edgecollective/sweet-p/ver_0.3/firmware/grassnomads/v1.0_return/README.txt

This is the state of the code when the device was returned in late Nov 2023 in order to add gps + timing and swap in a new sensor.
