edgecollective/sweet-p/ver_1/firmware/bayou.png

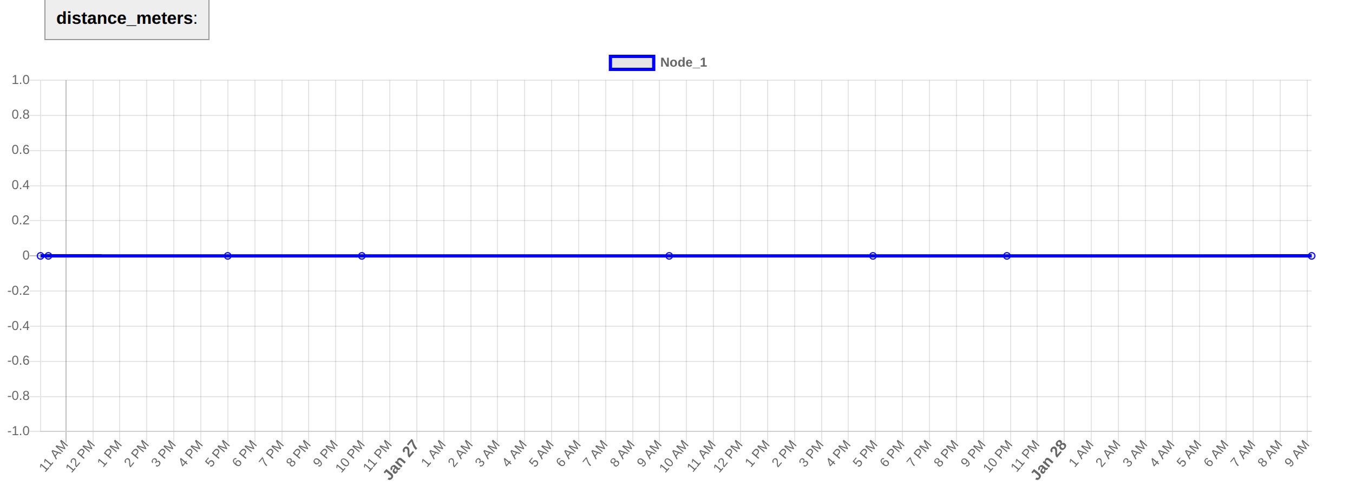
ver_1/firmware/bayou.png
