edgecollective/sweet-p/ver_0.4b/references/rockblock_cad/RockBLOCK_2_C.STEP

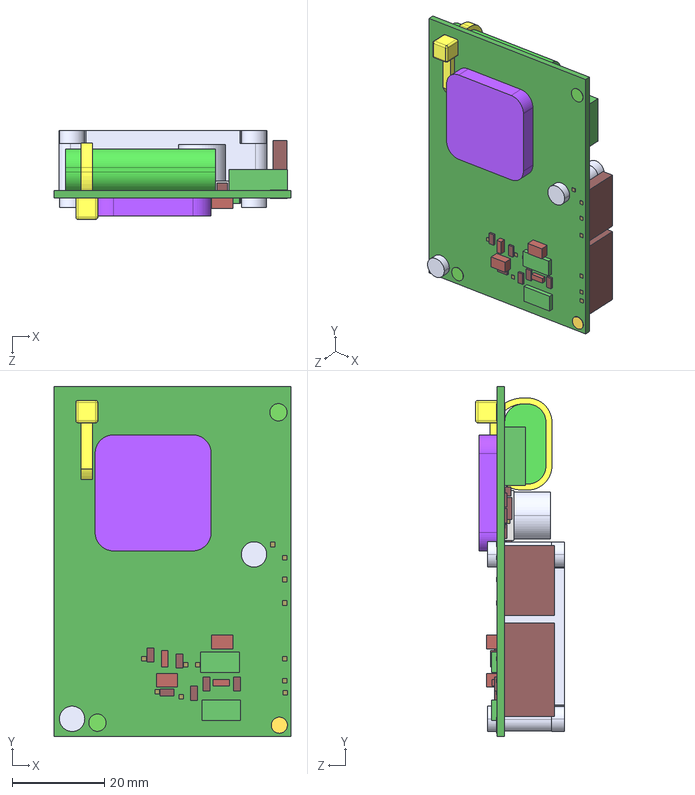
[picture p2: CAD file, 2023-05-05]
ver_0.4b/references/rockblock_cad/RockBLOCK_2_C.STEP
51.4 x 76.0 x 19.3 mm
