edgecollective/sweet-p/ver_1/modem_shelf/modem_shelf.stl

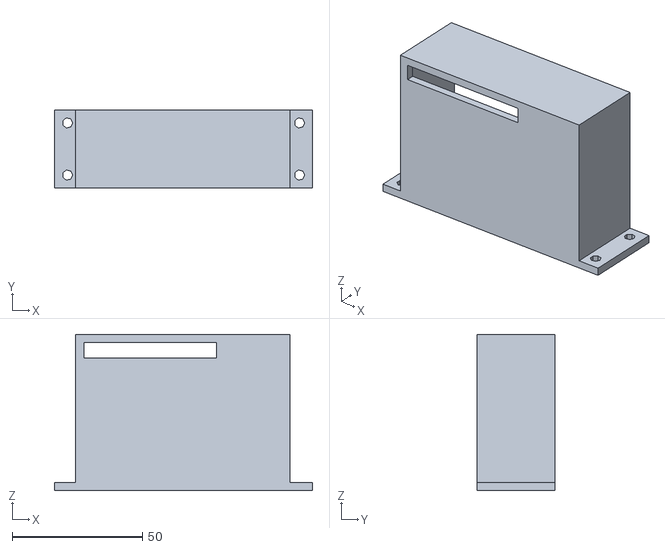
[picture p3: CAD file, 2025-12-08]
ver_1/modem_shelf/modem_shelf.stl
98.9 x 30.0 x 59.8
