edgecollective/sweet-p/(list of files, cad)

Other CAD files:
ver_0.4b/references/rockblock_cad/RockBLOCK_2_C (SMA).IGS
ver_0.4b/references/rockblock_cad/RockBLOCK_2_C.IGS
