edgecollective/sweet-p/ver_1/power_tests/3v3_to_adafruit_boost_1000.csv

Timestamp(ms) | Current(uA) | D0-D7
0 | 893.618 | 00000000
1000 | 328.765 | 00000000
2000 | 120.964 | 00000000
3000 | 44.520 | 00000000
4000 | 16.396 | 00000000
5000 | 6.052 | 00000000
6000 | 2763.313 | 00000000
7000 | 9912.000 | 00000000
8000 | 13029.475 | 00000000
9000 | 14181.139 | 00000000
10000 | 14470.309 | 00000000
11000 | 15074.997 | 00000000
12000 | 15029.870 | 00000000
13000 | 15384.849 | 00000000
14000 | 15185.409 | 00000000
15000 | 15153.102 | 00000000
16000 | 15122.245 | 00000000
17000 | 14982.114 | 00000000
18000 | 14971.494 | 00000000
19000 | 14884.330 | 00000000
20000 | 14808.294 | 00000000
21000 | 14660.663 | 00000000
22000 | 14685.264 | 00000000
23000 | 10569.829 | 00000000
24000 | 7407.893 | 00000000
25000 | 6232.191 | 00000000
26000 | 5717.780 | 00000000
27000 | 5602.246 | 00000000
28000 | 5492.494 | 00000000
29000 | 5421.319 | 00000000
30000 | 5391.076 | 00000000
31000 | 5364.958 | 00000000
32000 | 5301.172 | 00000000
33000 | 5254.912 | 00000000
34000 | 5259.111 | 00000000
35000 | 5226.554 | 00000000
36000 | 5184.181 | 00000000
37000 | 5135.263 | 00000000
38000 | 5225.625 | 00000000
39000 | 5140.500 | 00000000
40000 | 5096.870 | 00000000
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
