edgecollective/sweet-p/ver_1/power_tests/3v3_to_adafruit_boost_with_sat_send.csv

Timestamp(ms) | Current(uA) | D0-D7
0 | 4711.232 | 00000000
10 | 4684.063 | 00000000
20 | 4508.034 | 00000000
30 | 4260.355 | 00000000
40 | 4017.081 | 00000000
50 | 3752.968 | 00000000
60 | 4064.977 | 00000000
70 | 3647.355 | 00000000
80 | 3818.053 | 00000000
90 | 3707.150 | 00000000
100 | 3705.720 | 00000000
110 | 4114.174 | 00000000
120 | 4046.989 | 00000000
130 | 4182.540 | 00000000
140 | 4110.196 | 00000000
150 | 4055.243 | 00000000
160 | 3923.804 | 00000000
170 | 3990.117 | 00000000
180 | 4363.126 | 00000000
190 | 3653.594 | 00000000
200 | 3743.150 | 00000000
210 | 3729.171 | 00000000
220 | 4014.052 | 00000000
230 | 3737.505 | 00000000
240 | 3727.884 | 00000000
250 | 3765.068 | 00000000
260 | 3748.979 | 00000000
270 | 3766.070 | 00000000
280 | 3608.509 | 00000000
290 | 3885.023 | 00000000
300 | 4092.578 | 00000000
310 | 4128.807 | 00000000
320 | 4155.380 | 00000000
330 | 4290.182 | 00000000
340 | 4132.554 | 00000000
350 | 3974.280 | 00000000
360 | 4153.649 | 00000000
370 | 4197.875 | 00000000
380 | 4343.990 | 00000000
390 | 4159.344 | 00000000
400 | 3991.450 | 00000000
410 | 4021.465 | 00000000
420 | 4406.368 | 00000000
430 | 3996.783 | 00000000
440 | 4149.331 | 00000000
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
