edgecollective/sweet-p/ver_1/power_tests/5v_direct_to_5V_timer.csv

Timestamp(ms) | Current(uA) | D0-D7
0 | 0.450 | 00000000
1000 | 0.417 | 00000000
2000 | 0.403 | 00000000
3000 | 0.400 | 00000000
4000 | 0.397 | 00000000
5000 | 0.402 | 00000000
6000 | 8020.614 | 00000000
7000 | 13746.493 | 00000000
8000 | 16043.112 | 00000000
9000 | 16042.970 | 00000000
10000 | 17601.664 | 00000000
11000 | 17647.559 | 00000000
12000 | 18718.426 | 00000000
13000 | 18962.887 | 00000000
14000 | 19051.184 | 00000000
15000 | 19063.414 | 00000000
16000 | 19054.027 | 00000000
17000 | 19532.229 | 00000000
18000 | 19453.771 | 00000000
19000 | 19283.441 | 00000000
20000 | 19206.611 | 00000000
21000 | 19178.738 | 00000000
22000 | 19155.977 | 00000000
23000 | 19137.457 | 00000000
24000 | 19126.262 | 00000000
25000 | 19111.102 | 00000000
26000 | 19102.500 | 00000000
27000 | 19084.166 | 00000000
28000 | 20562.332 | 00000000
29000 | 20379.383 | 00000000
30000 | 19892.955 | 00000000
31000 | 19575.816 | 00000000
32000 | 19622.930 | 00000000
33000 | 19717.965 | 00000000
34000 | 19896.803 | 00000000
35000 | 20085.561 | 00000000
36000 | 19633.721 | 00000000
37000 | 19504.172 | 00000000
38000 | 20671.521 | 00000000
39000 | 25430.527 | 00000000
40000 | 34560.559 | 00000000
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
