edgecollective/sweet-p/ver_1/power_tests/amazon_boost_from_5V_direct_jan_14_2142.csv

Timestamp(ms) | Current(uA) | D0-D7
0 | 114937.688 | 00000000
1000 | 121255.969 | 00000000
2000 | 126080.289 | 00000000
3000 | 130029.781 | 00000000
4000 | 133418.047 | 00000000
5000 | 136607.484 | 00000000
6000 | 139536.828 | 00000000
7000 | 142125.109 | 00000000
8000 | 143671.891 | 00000000
9000 | 142532.438 | 00000000
10000 | 137865.125 | 00000000
11000 | 132348.594 | 00000000
12000 | 127357.805 | 00000000
13000 | 122535.289 | 00000000
14000 | 118210.492 | 00000000
15000 | 114508.422 | 00000000
16000 | 111995.164 | 00000000
17000 | 108680.805 | 00000000
18000 | 106043.789 | 00000000
19000 | 103910.211 | 00000000
20000 | 101921.086 | 00000000
21000 | 101176.305 | 00000000
22000 | 104139.992 | 00000000
23000 | 108209.227 | 00000000
24000 | 112506.328 | 00000000
25000 | 116837.414 | 00000000
26000 | 121263.555 | 00000000
27000 | 125396.406 | 00000000
28000 | 129110.453 | 00000000
29000 | 132328.672 | 00000000
30000 | 135395.438 | 00000000
31000 | 138301.094 | 00000000
32000 | 141015.188 | 00000000
33000 | 143397.016 | 00000000
34000 | 144036.328 | 00000000
35000 | 139848.938 | 00000000
36000 | 134449.531 | 00000000
37000 | 129028.578 | 00000000
38000 | 123875.164 | 00000000
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
