edgecollective/sweet-p/ver_1/power_tests/ave_over_many_non_sends.csv

Timestamp(ms) | Current(uA) | D0-D7
0 | 393.370 | 00000000
1000 | 144.728 | 00000000
2000 | 53.250 | 00000000
3000 | 1105.946 | 00000000
4000 | 12868.263 | 00000000
5000 | 18156.475 | 00000000
6000 | 20253.467 | 00000000
7000 | 20578.154 | 00000000
8000 | 22172.422 | 00000000
9000 | 22199.475 | 00000000
10000 | 23359.641 | 00000000
11000 | 23327.826 | 00000000
12000 | 23318.816 | 00000000
13000 | 23367.193 | 00000000
14000 | 23320.934 | 00000000
15000 | 23327.588 | 00000000
16000 | 23308.443 | 00000000
17000 | 23325.521 | 00000000
18000 | 23295.471 | 00000000
19000 | 23359.605 | 00000000
20000 | 14575.374 | 00000000
21000 | 5985.008 | 00000000
22000 | 2813.862 | 00000000
23000 | 1656.904 | 00000000
24000 | 1237.142 | 00000000
25000 | 1094.937 | 00000000
26000 | 1021.700 | 00000000
27000 | 1010.118 | 00000000
28000 | 996.412 | 00000000
29000 | 970.329 | 00000000
30000 | 981.474 | 00000000
31000 | 996.055 | 00000000
32000 | 1000.156 | 00000000
33000 | 972.854 | 00000000
34000 | 973.917 | 00000000
35000 | 987.651 | 00000000
36000 | 1000.270 | 00000000
37000 | 974.423 | 00000000
38000 | 985.599 | 00000000
39000 | 991.062 | 00000000
40000 | 980.608 | 00000000
41000 | 990.356 | 00000000
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
