edgecollective/sweet-p/ver_1/power_tests/boost_and_sat_full_cycle.csv

Timestamp(ms) | Current(uA) | D0-D7
0 | 388.027 | 00000000
1000 | 142.770 | 00000000
2000 | 483323.281 | 00000000
3000 | 888664.375 | 00000000
4000 | 1034955.625 | 00000000
5000 | 1091002.500 | 00000000
6000 | 1066258.875 | 00000000
7000 | 901453.188 | 00000000
8000 | 753140.688 | 00000000
9000 | 632702.063 | 00000000
10000 | 536028.313 | 00000000
11000 | 461830.063 | 00000000
12000 | 402696.938 | 00000000
13000 | 354787.250 | 00000000
14000 | 316307.375 | 00000000
15000 | 283209.938 | 00000000
16000 | 255524.969 | 00000000
17000 | 231928.516 | 00000000
18000 | 211351.297 | 00000000
19000 | 194154.375 | 00000000
20000 | 179773.734 | 00000000
21000 | 171463.656 | 00000000
22000 | 158958.438 | 00000000
23000 | 143430.047 | 00000000
24000 | 132808.500 | 00000000
25000 | 120411.609 | 00000000
26000 | 109782.992 | 00000000
27000 | 101049.172 | 00000000
28000 | 94261.555 | 00000000
29000 | 88413.359 | 00000000
30000 | 83443.773 | 00000000
31000 | 79172.977 | 00000000
32000 | 74864.313 | 00000000
33000 | 70709.469 | 00000000
34000 | 79750.367 | 00000000
35000 | 95003.711 | 00000000
36000 | 111140.719 | 00000000
37000 | 128621.125 | 00000000
38000 | 140207.609 | 00000000
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
