edgecollective/sweet-p/ver_1/sweet-p.kicad_pcb

## KiCad design ver_1/sweet-p.kicad_pcb (2025-10-10)

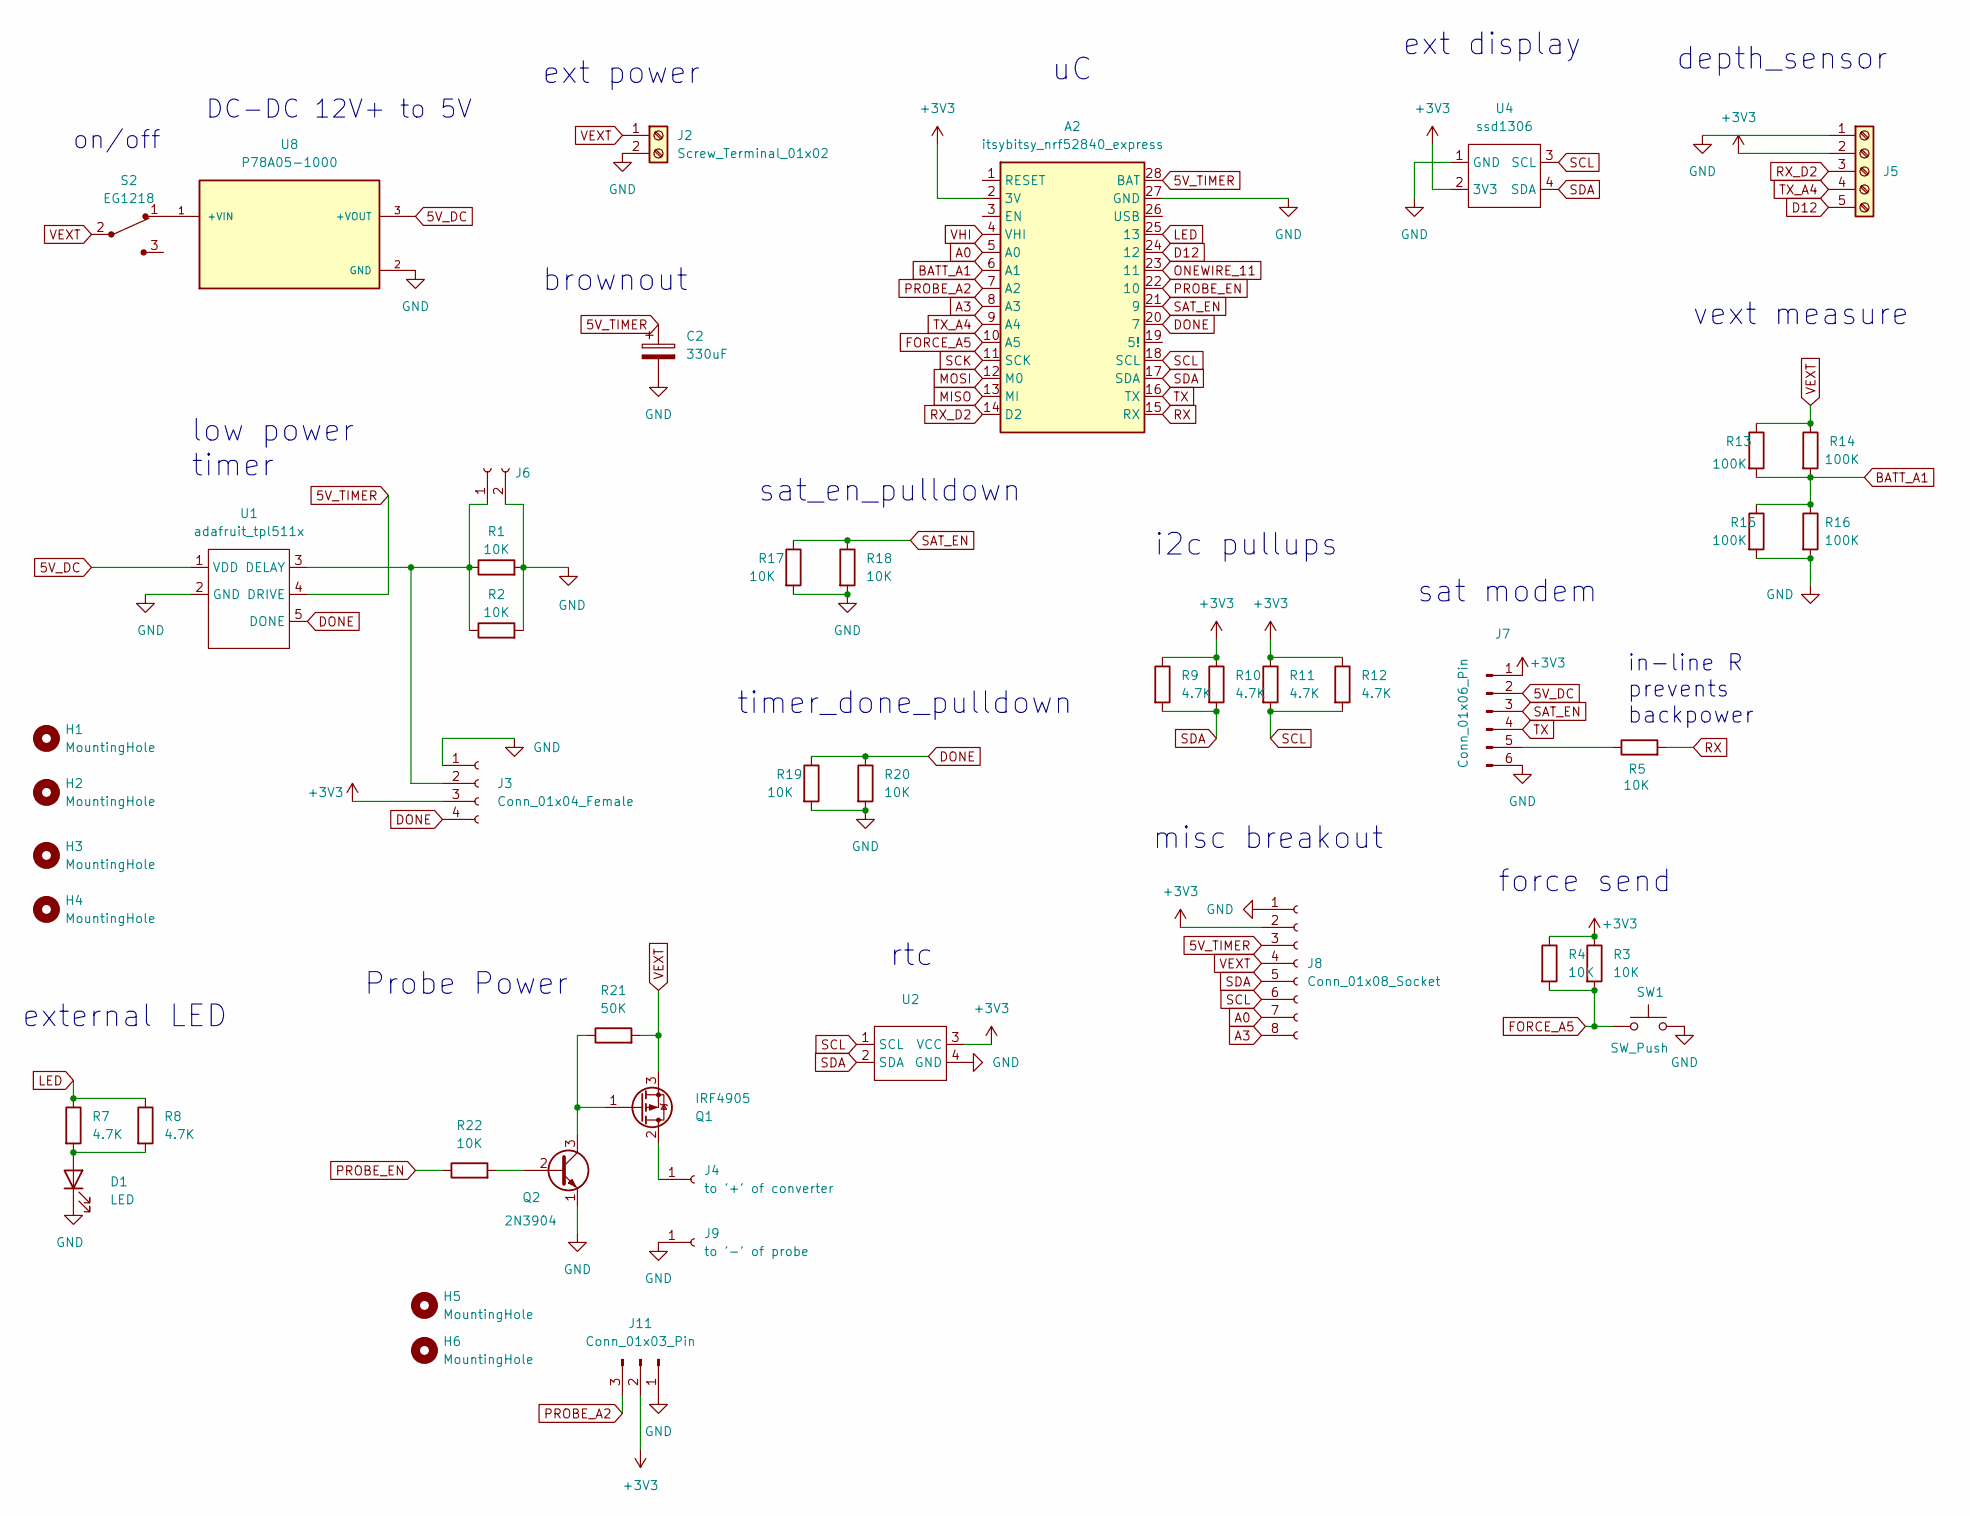
[picture p5: schematic sweet-p.kicad_sch]

Parts:
A2: itsybitsy_nrf52840_express; itsybitsy
C2: 330uF; CP_Radial_D5.0mm_P2.00mm
D1: LED; LED_D5.0mm
H1, H2, H3, H4, H5, H6: MountingHole; MountingHole_3.2mm_M3
J2: Screw_Terminal_01x02; TerminalBlock_Phoenix_PT-1,5-2-5.0-H_1x02_P5.00mm_Horizontal
J3: Conn_01x04_Female; PinSocket_1x04_P2.54mm_Vertical
J4: to '+' of converter; PinSocket_1x01_P2.54mm_Vertical
J5: Screw_Terminal_01x05; TerminalBlock_Phoenix_MKDS-1,5-5-5.08_1x05_P5.08mm_Horizont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
J6: Conn_01x02_Socket; PinSocket_1x02_P2.54mm_Vertical
J7: Conn_01x06_Pin; PinHeader_1x06_P2.54mm_Vertical
J8: Conn_01x08_Socket; PinSocket_1x08_P2.54mm_Vertical
J9: to '-' of probe; PinSocket_1x01_P2.54mm_Vertical
J11: Conn_01x03_Pin; PinHeader_1x03_P2.54mm_Vertical
Q1: IRF4905; TO-220-3_Vertical
Q2: 2N3904; TO-92_Inline
R1, R3, R18, R20: 10K; R_0603_1608Metric_Pad0.98x0.95mm_HandSolder
R2, R4, R5, R17, R19, R22: 10K; R_Axial_DIN0204_L3.6mm_D1.6mm_P7.62mm_Horizontal
R7, R9, R12: 4.7K; R_Axial_DIN0204_L3.6mm_D1.6mm_P7.62mm_Horizontal
R8, R10, R11: 4.7K; R_0603_1608Metric_Pad0.98x0.95mm_HandSolder
R13, R15: 100K; R_Axial_DIN0204_L3.6mm_D1.6mm_P7.62mm_Horizontal
R14, R16: 100K; R_0603_1608Metric_Pad0.98x0.95mm_HandSolder
R21: 50K; R_Axial_DIN0204_L3.6mm_D1.6mm_P7.62mm_Horizontal
S2: EG1218; Switch_Slide_11.6x4mm_EG1218; MPN EG1218; Digi-Key_PN EG1903-ND
SW1: SW_Push; SW_PUSH_6mm
U1: adafruit_tpl511x
U2: ds3231_amazon
U4: ssd1306; ssd1306_a
U8: P78A05-1000; CONV_P78A05-1000; PARTREV 1.0

Connections:
5V_DC: J7.2, U1.1 (VDD), U8.3 (+VOUT)
5V_TIMER: A2.28 (BAT), C2.1, J8.3, U1.4 (DRIVE)
+3V3: A2.2 (3V), J3.3, J5.2, J7.1, J8.2, J11.2, R3.1, R4.1, R9.1, R10.1, R11.1, R12.1, U2.3 (VCC), U4.2 (3V3)
A0: A2.5 (A0), J8.7
A3: A2.8 (A3), J8.8
BATT_A1: A2.6 (A1), R13.2, R14.2, R15.1, R16.1
D12: A2.24 (12), J5.5
DONE: A2.20 (7), J3.4, R19.1, R20.1, U1.5 (DONE)
FORCE_A5: A2.10 (A5), R3.2, R4.2, SW1.1
GND: A2.27 (GND), C2.2, D1.1 (K), J2.2, J3.1, J5.1, J6.2, J7.6, J8.1, J9.1, J11.1, Q2.1 (E), R1.2, R2.2, R15.2, R16.2, R17.2, R18.2, R19.2, R20.2, SW1.2, U1.2 (GND), U2.4 (GND), U4.1 (GND), U8.2 (GND)
LED: A2.25 (13), R7.1, R8.1
MISO: A2.13 (MI)
MOSI: A2.12 (M0)
unnamed: D1.2 (A), R7.2, R8.2
unnamed: J3.2, J6.1, R1.1, R2.1, U1.3 (DELAY)
unnamed: J4.1, Q1.2 (D)
unnamed: J7.5, R5.1
unnamed: Q1.1 (G), Q2.3 (C), R21.1
unnamed: Q2.2 (B), R22.2
unnamed: S2.1, U8.1 (+VIN)
ONEWIRE_11: A2.23 (11)
PROBE_A2: A2.7 (A2), J11.3
PROBE_EN: A2.22 (10), R22.1
RX: A2.15 (RX), R5.2
RX_D2: A2.14 (D2), J5.3
SAT_EN: A2.21 (9), J7.3, R17.1, R18.1
SCK: A2.11 (SCK)
SCL: A2.18 (SCL), J8.6, R11.2, R12.2, U2.1 (SCL), U4.3 (SCL)
SDA: A2.17 (SDA), J8.5, R9.2, R10.2, U2.2 (SDA), U4.4 (SDA)
TX: A2.16 (TX), J7.4
TX_A4: A2.9 (A4), J5.4
VEXT: J2.1, J8.4, Q1.3 (S), R13.1, R14.1, R21.2, S2.2
VHI: A2.4 (VHI)

Notes on the sheet:
force send
sat modem
brownout
DC-DC 12V+ to 5V
sat_en_pulldown
vext measure
misc breakout
timer_done_pulldown
in-line R prevents backpower
on/off
i2c pullups
external LED
depth_sensor
low power timer
ext power
ext display
Probe Power
rtc

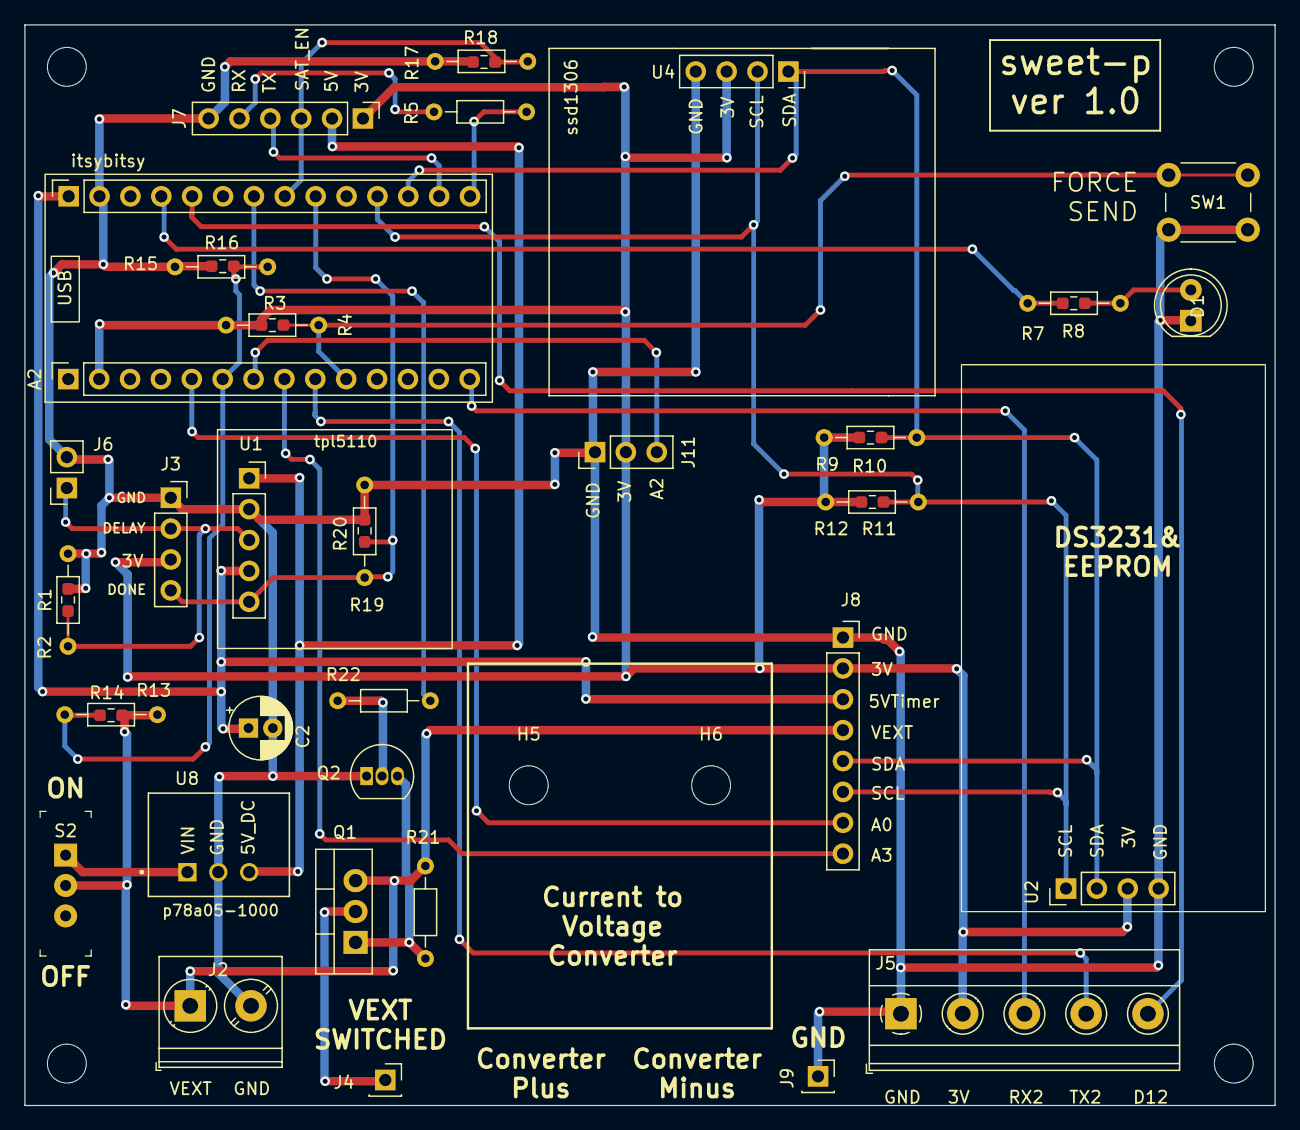
[picture p6: board ver_1/sweet-p.kicad_pcb from above]

Board: 2 copper layers, 102.8 x 88.9 mm, 47 parts (0 on the bottom side), 28 nets.
