edgecollective/sweet-p/ver_0.3/sweet-p.kicad_pcb

## KiCad design ver_0.3/sweet-p.kicad_pcb (2023-07-26, an earlier design)

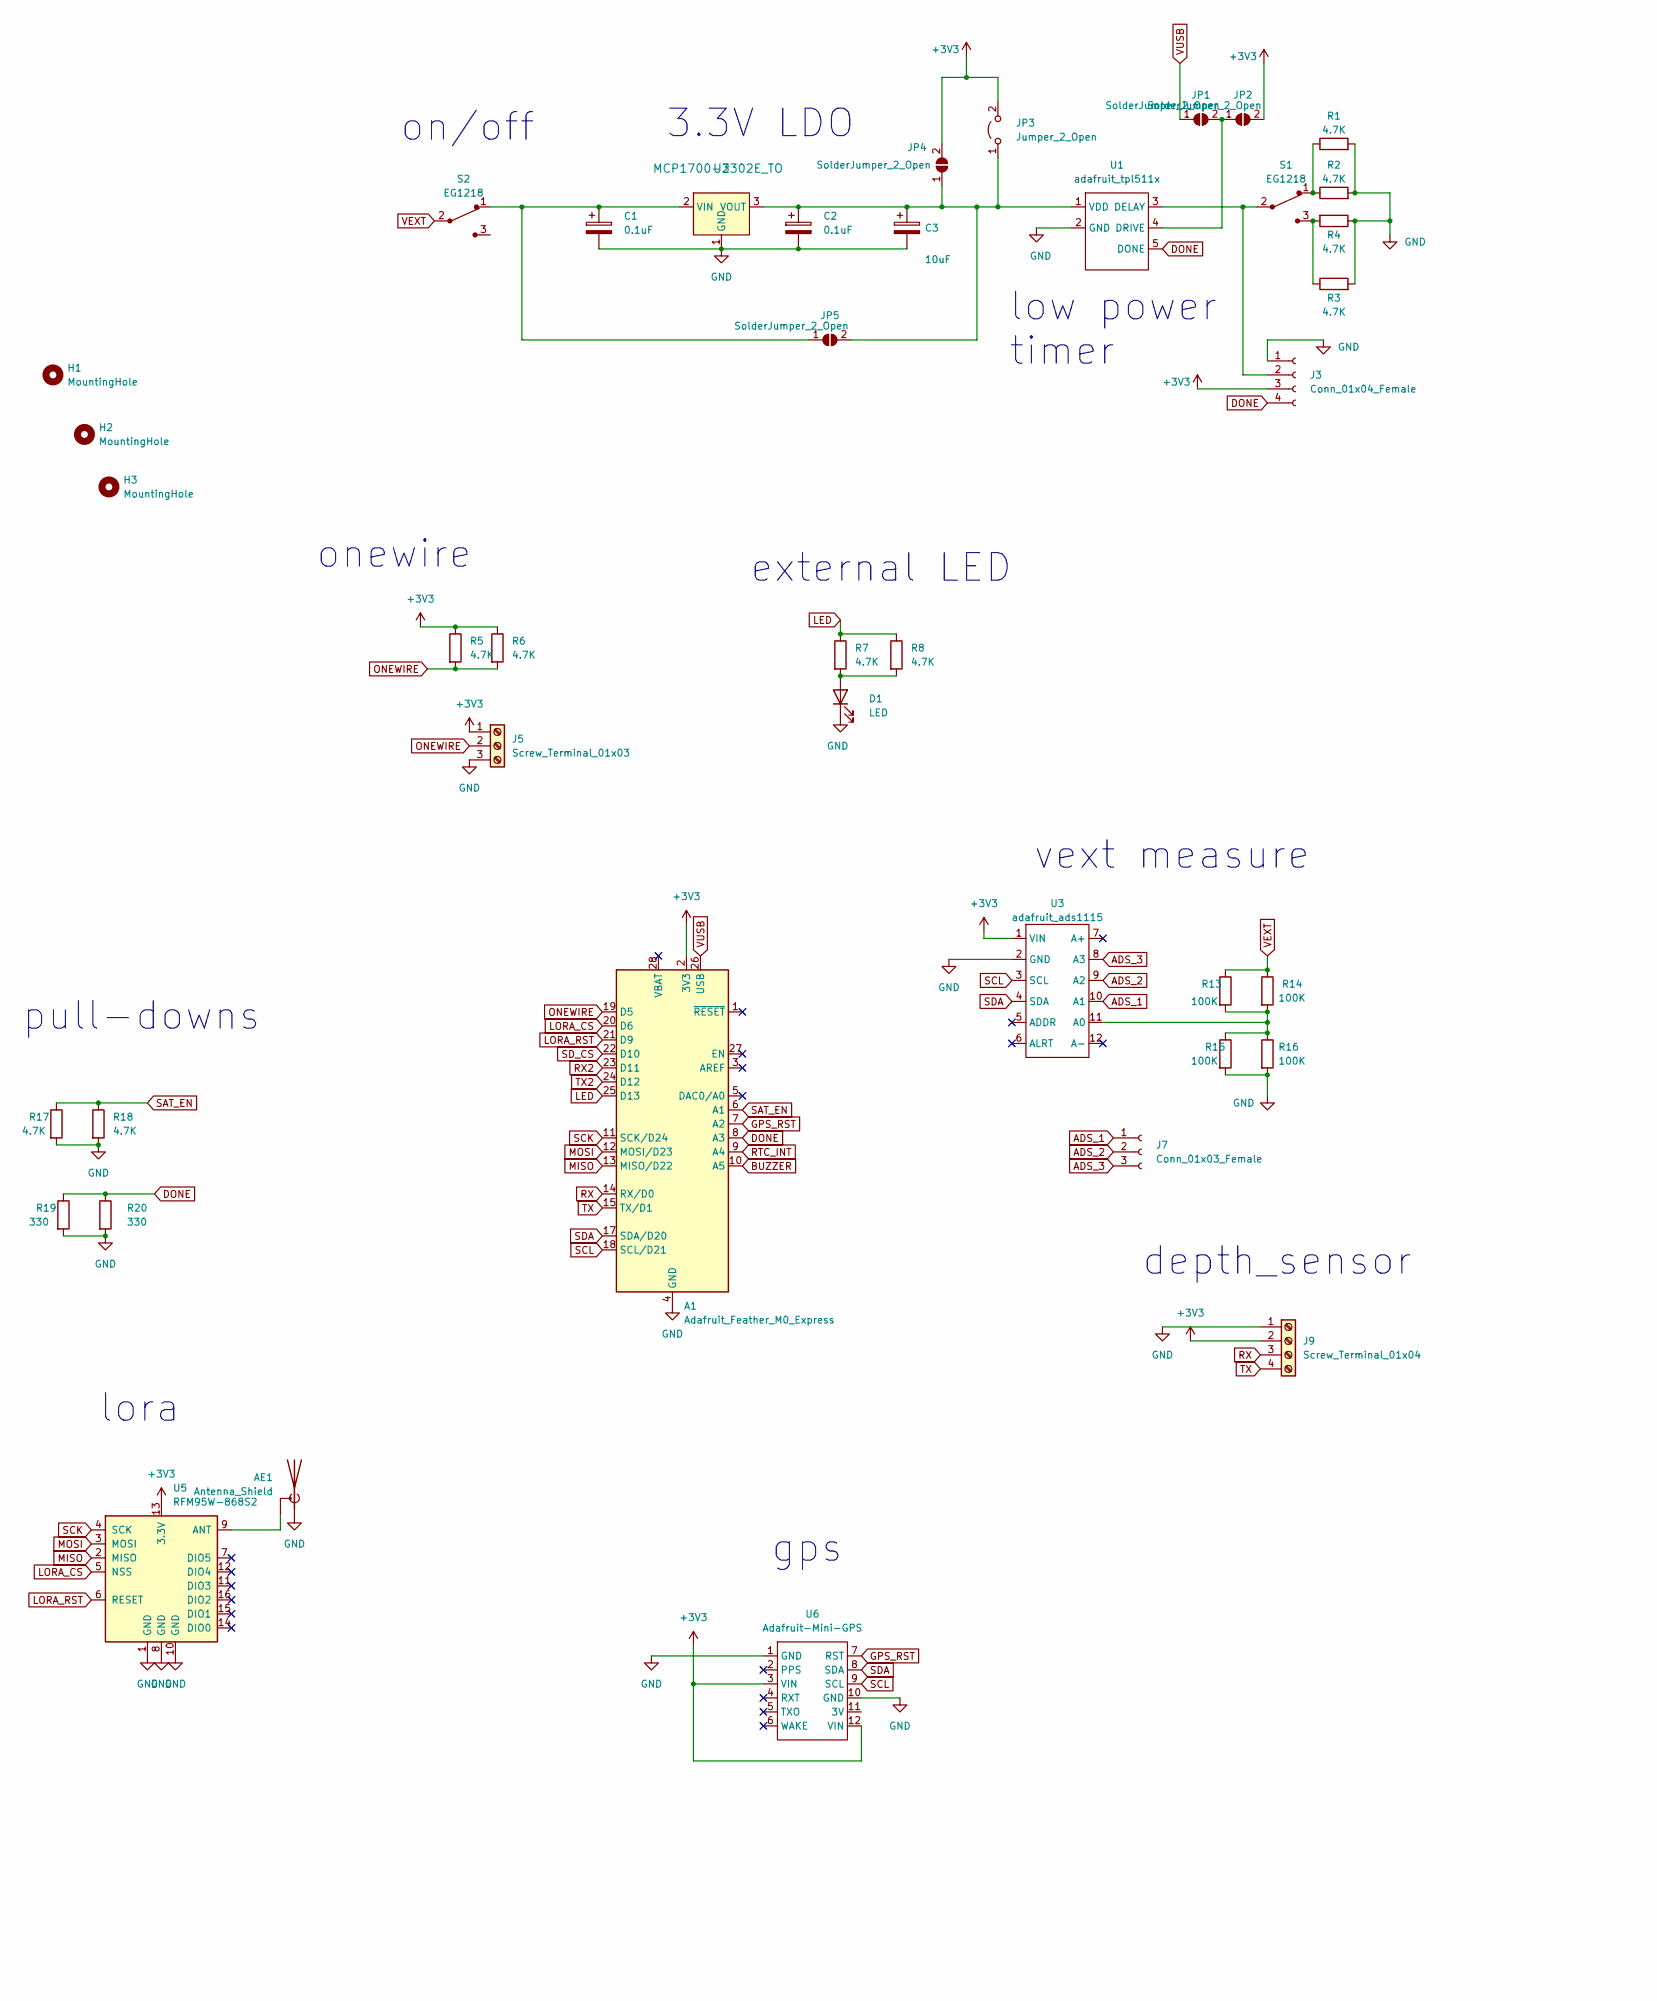
[picture p7: schematic sweet-p.kicad_sch, part in row 1, column 1]

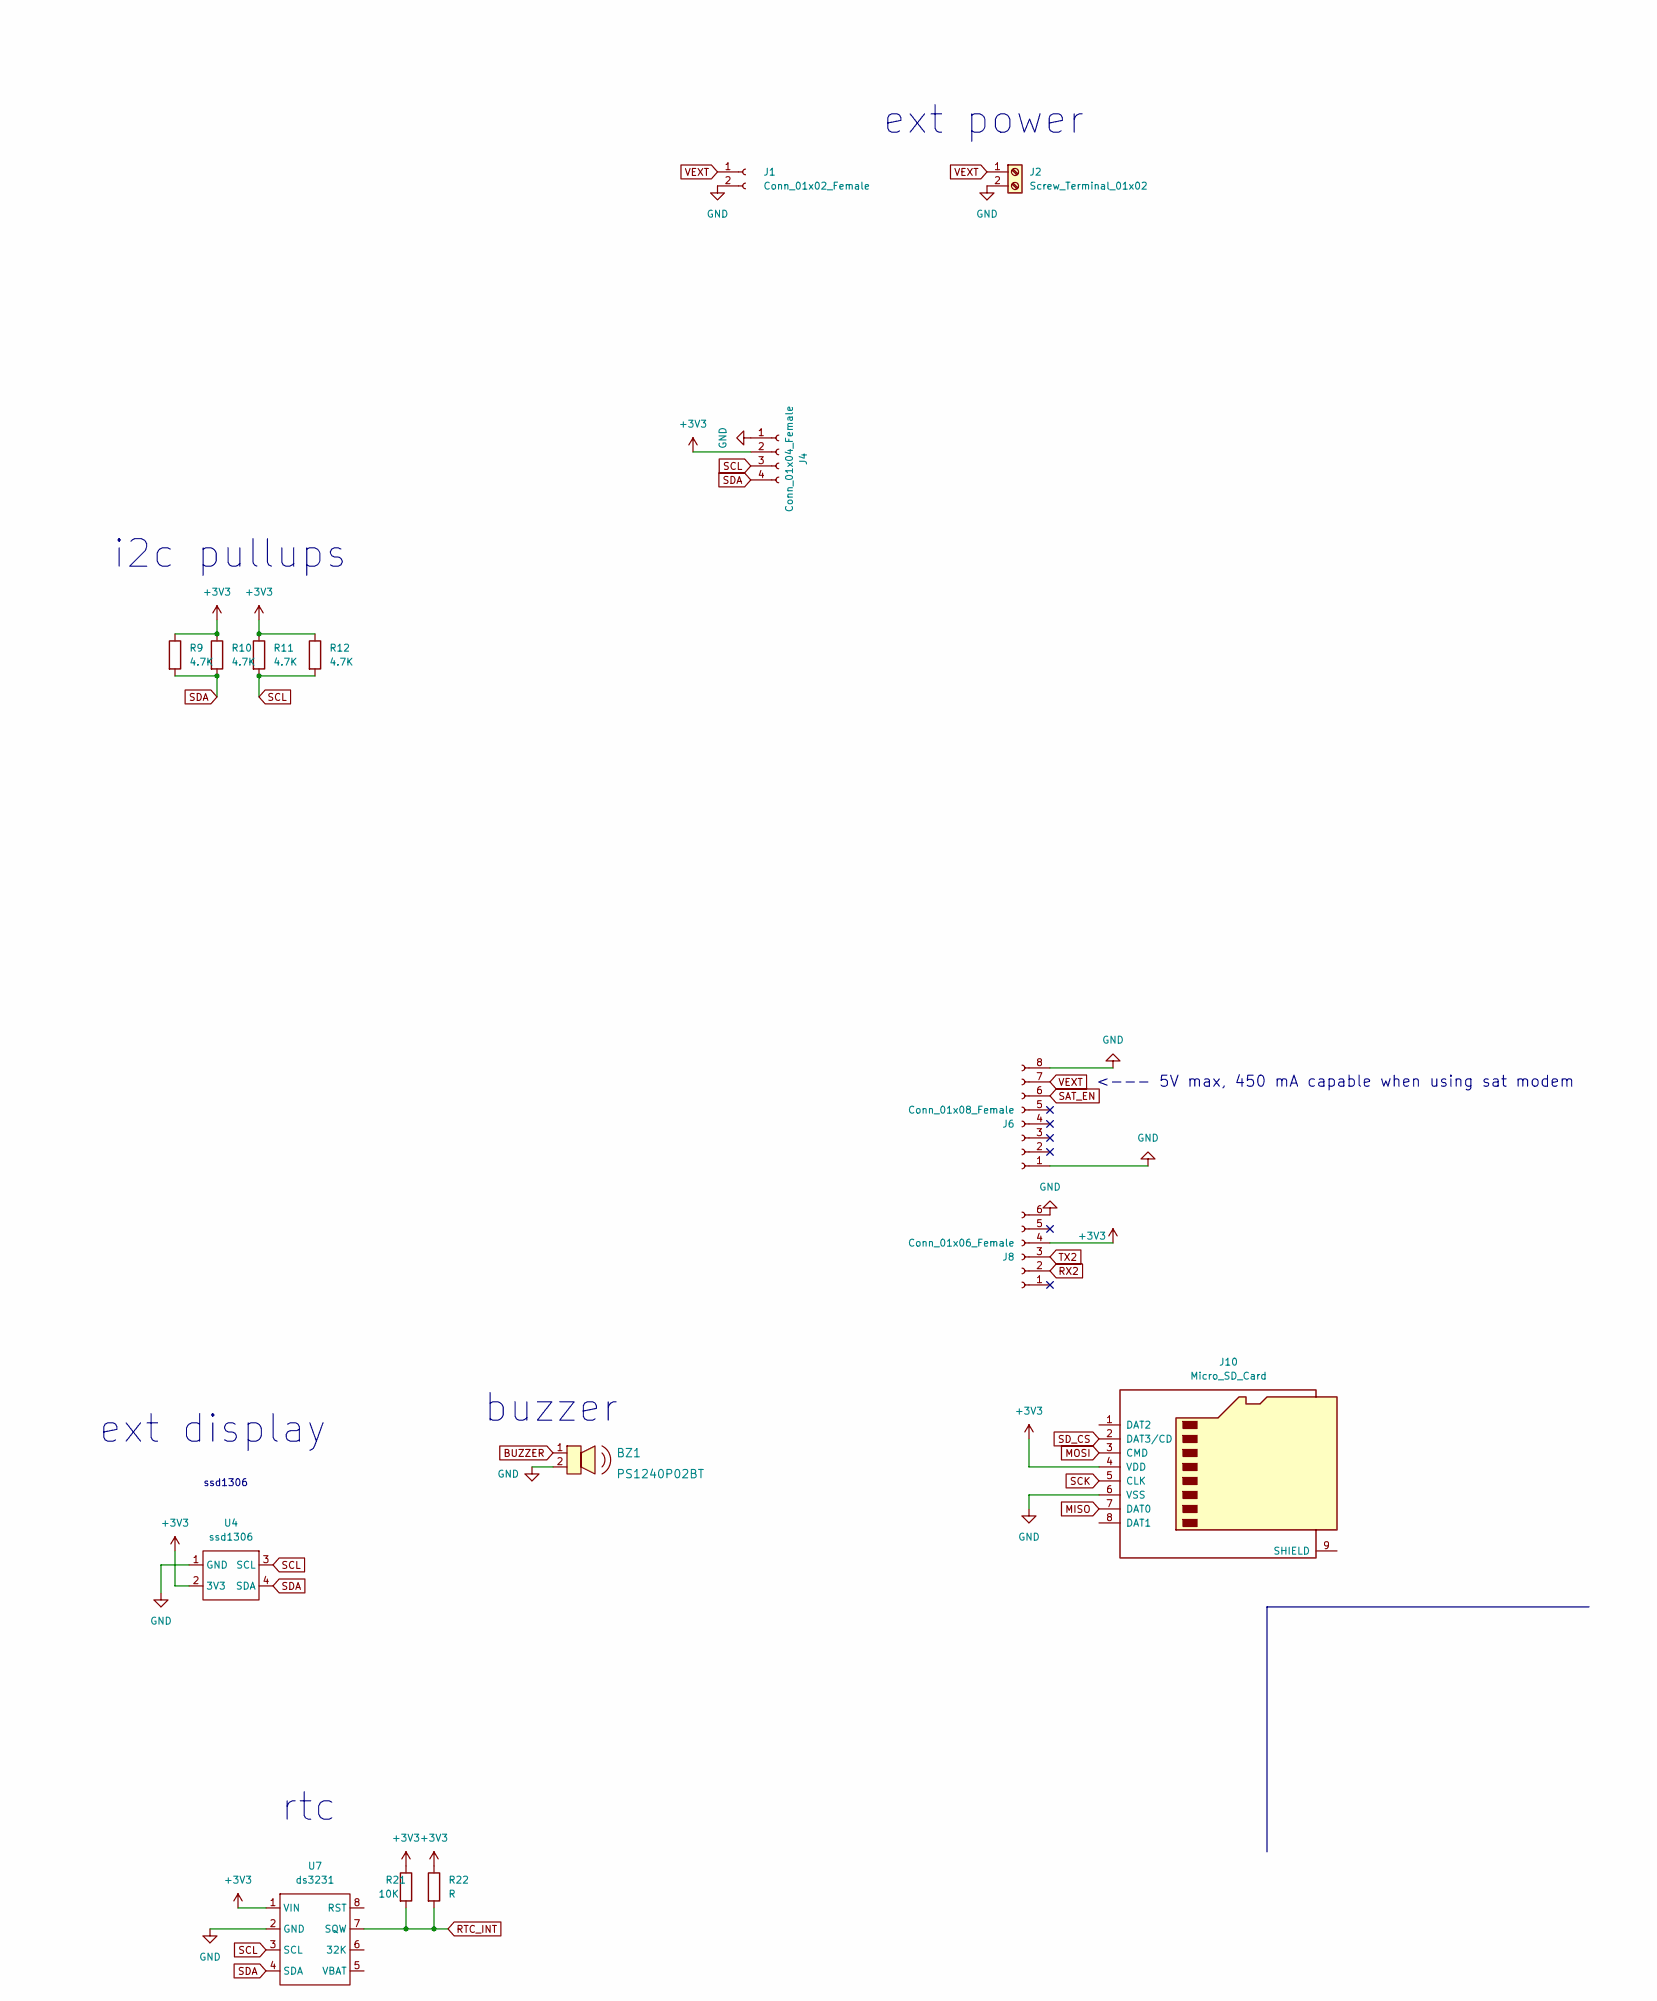
[picture p8: schematic sweet-p.kicad_sch, part in row 1, column 2]

Parts:
A1: Adafruit_Feather_M0_Express; Adafruit_Feather
AE1: Antenna_Shield; RF_SMA_Vertical_5-1814832-1
BZ1: PS1240P02BT; Piezo_Transducer_THT_PS1240P02BT; MPN PS1240P02BT; Digi-Key_PN 445-2525-1-ND
C1, C2: 0.1uF; CP_Radial_Tantal_D4.5mm_P2.50mm
C3: 10uF; CP_Radial_Tantal_D4.5mm_P2.50mm
D1: LED; LED_D5.0mm
H1, H2, H3: MountingHole; MountingHole_3.2mm_M3
J1: Conn_01x02_Female; JST_PH_B2B-PH-K_1x02_P2.00mm_Vertical
J2: Screw_Terminal_01x02; TerminalBlock_Phoenix_PT-1,5-2-5.0-H_1x02_P5.00mm_Horizontal
J3, J4: Conn_01x04_Female; PinSocket_1x04_P2.54mm_Vertical
J5: Screw_Terminal_01x03; TerminalBlock_Phoenix_PT-1,5-3-5.0-H_1x03_P5.00mm_Horizontal
J6: Conn_01x08_Female; PinSocket_1x08_P2.54mm_Vertical
J7: Conn_01x03_Female; PinSocket_1x03_P2.54mm_Vertical
J8: Conn_01x06_Female; PinSocket_1x06_P2.54mm_Vertical
J9: Screw_Terminal_01x04; TerminalBlock_Phoenix_PT-1,5-4-5.0-H_1x04_P5.00mm_Horizontal
J10: Micro_SD_Card; DM3D-SF_outline
JP1, JP2, JP4, JP5: SolderJumper_2_Open; SolderJumper-2_P1.3mm_Open_Pad1.0x1.5mm
JP3: Jumper_2_Open; PinHeader_1x02_P2.54mm_Vertical
R1, R3, R6, R8, R10, R11, R18: 4.7K; R_0603_1608Metric_Pad0.98x0.95mm_HandSolder
R2, R4, R5, R7, R9, R12, R17: 4.7K; R_Axial_DIN0204_L3.6mm_D1.6mm_P7.62mm_Horizontal
R13, R15: 100K; R_Axial_DIN0204_L3.6mm_D1.6mm_P7.62mm_Horizontal
R14, R16: 100K; R_0603_1608Metric_Pad0.98x0.95mm_HandSolder
R19: 330; R_Axial_DIN0204_L3.6mm_D1.6mm_P7.62mm_Horizontal
R20: 330; R_0603_1608Metric_Pad0.98x0.95mm_HandSolder
R21: 10K; R_0603_1608Metric_Pad0.98x0.95mm_HandSolder
R22: R; R_Axial_DIN0204_L3.6mm_D1.6mm_P7.62mm_Horizontal
S1, S2: EG1218; Switch_Slide_11.6x4mm_EG1218; MPN EG1218; Digi-Key_PN EG1903-ND
U1: adafruit_tpl511x
U2: MCP1700-3302E_TO; TO-92-3; MPN MCP1700-3302E/TO; Digi-Key_PN MCP1700-3302E/TO-ND
U3: adafruit_ads1115
U4: ssd1306; ssd1306_a
U5: RFM95W-868S2; HOPERF_RFM9XW_SMD
U6: Adafruit-Mini-GPS; adafruit_mini_gps
U7: ds3231; ds3231_adafruit_breakout

Connections:
+3V3: A1.2 (3V3), J3.3, J4.2, J5.1, J8.4, J9.2, J10.4 (VDD), JP2.2 (B), JP3.2 (B), JP4.2 (B), R5.1, R6.1, R9.1, R10.1, R11.1, R12.1, R21.1, R22.1, U3.1 (VIN), U4.2 (3V3), U5.13 (3.3V), U6.3 (VIN), U6.12 (VIN), U7.1 (VIN)
ADS_1: J7.1, U3.10 (A1)
ADS_2: J7.2, U3.9 (A2)
ADS_3: J7.3, U3.8 (A3)
BUZZER: A1.10 (A5), BZ1.1
DONE: A1.8 (A3), J3.4, R19.1, R20.1, U1.5 (DONE)
GND: A1.4 (GND), A1.16 (GND), AE1.1 (A), BZ1.2, C1.2, C2.2, C3.2, D1.1 (K), J1.2, J2.2, J3.1, J4.1, J5.3, J6.1, J6.8, J8.6, J9.1, J10.6 (VSS), R1.2, R2.2, R3.1, R4.2, R15.2, R16.2, R17.2, R18.2, R19.2, R20.2, U1.2 (GND), U2.1 (GND), U3.2 (GND), U4.1 (GND), U5.1 (GND), U5.8 (GND), U5.10 (GND), U6.1 (GND), U6.10 (GND), U7.2 (GND)
GPS_RST: A1.7 (A2), U6.7 (RST)
LED: A1.25 (D13), R7.1, R8.1
LORA_CS: A1.20 (D6), U5.5 (NSS)
LORA_RST: A1.21 (D9), U5.6 (RESET)
MISO: A1.13 (MISO/D22), J10.7 (DAT0), U5.2 (MISO)
MOSI: A1.12 (MOSI/D23), J10.3 (CMD), U5.3 (MOSI)
unnamed: AE1.2 (Shield), U5.9 (ANT)
unnamed: C1.1, JP5.1 (A), S2.1, U2.2 (VIN)
unnamed: C2.1, C3.1, JP3.1 (A), JP4.1 (A), JP5.2 (B), U1.1 (VDD), U2.3 (VOUT)
unnamed: D1.2 (A), R7.2, R8.2
unnamed: R1.1, R2.1, S1.1
unnamed: R3.2, R4.1, S1.3
unnamed: R13.2, R14.2, R15.1, R16.1, U3.11 (A0)
unnamed: J3.2, S1.2, U1.3 (DELAY)
unnamed: JP1.2 (B), JP2.1 (A), U1.4 (DRIVE)
ONEWIRE: A1.19 (D5), J5.2, R5.2, R6.2
RTC_INT: A1.9 (A4), R21.2, R22.2, U7.7 (SQW)
RX: A1.14 (RX/D0), J9.3
RX2: A1.23 (D11), J8.2
SAT_EN: A1.6 (A1), J6.6, R17.1, R18.1
SCK: A1.11 (SCK/D24), J10.5 (CLK), U5.4 (SCK)
SCL: A1.18 (SCL/D21), J4.3, R11.2, R12.2, U3.3 (SCL), U4.3 (SCL), U6.9 (SCL), U7.3 (SCL)
SDA: A1.17 (SDA/D20), J4.4, R9.2, R10.2, U3.4 (SDA), U4.4 (SDA), U6.8 (SDA), U7.4 (SDA)
SD_CS: A1.22 (D10), J10.2 (DAT3/CD)
TX: A1.15 (TX/D1), J9.4
TX2: A1.24 (D12), J8.3
VEXT: J1.1, J2.1, J6.7, R13.1, R14.1, S2.2
VUSB: A1.26 (USB), JP1.1 (A)

Notes on the sheet:
buzzer
pull-downs
vext measure
gps
lora
<--- 5V max, 450 mA capable when using sat modem
onewire
on/off
i2c pullups
external LED
depth_sensor
low power timer
ext power
ext display
ssd1306
3.3V LDO
rtc

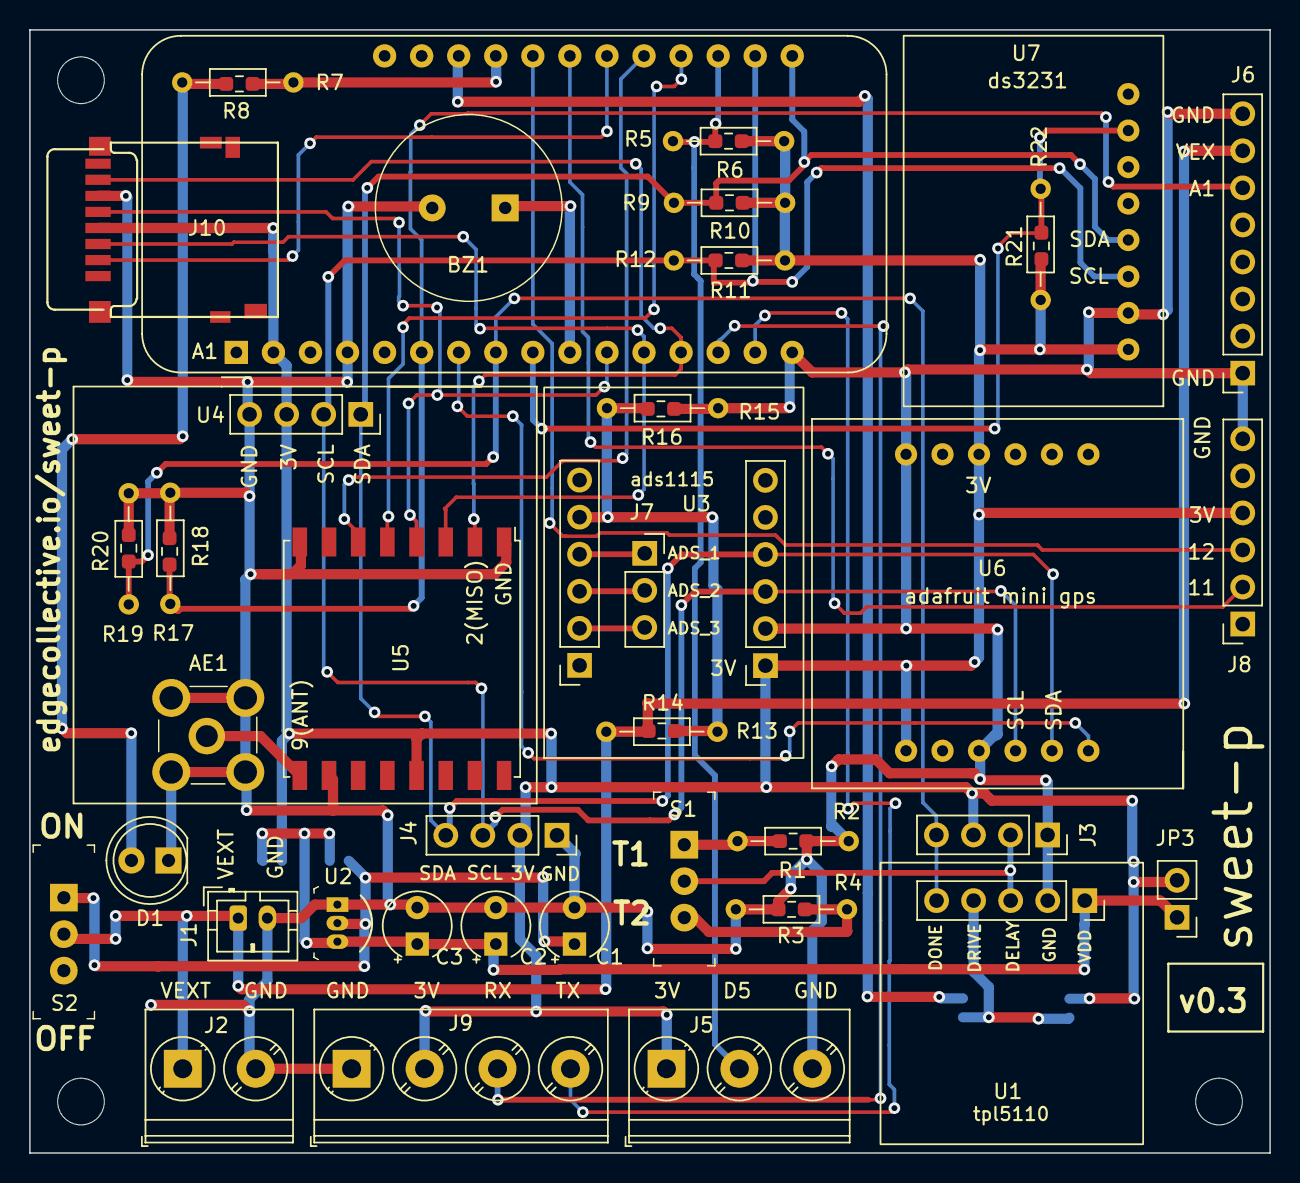
[picture p9: board ver_0.3/sweet-p.kicad_pcb from above]

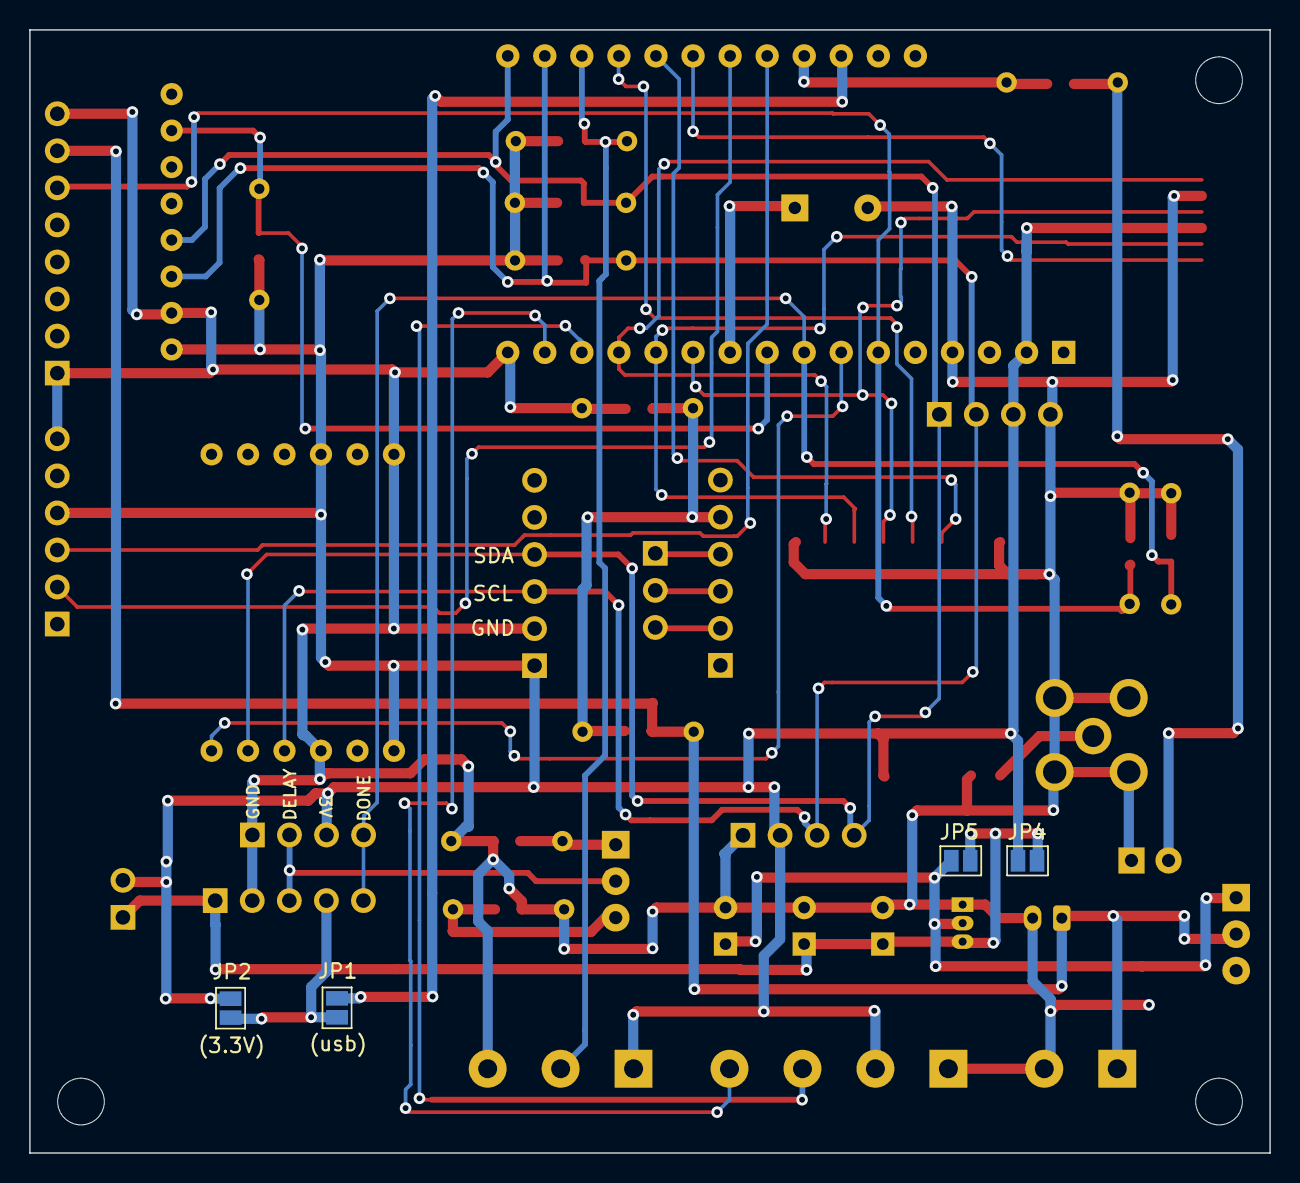
[picture p10: board ver_0.3/sweet-p.kicad_pcb from below]

Board: 2 copper layers, 85.0 x 77.0 mm, 56 parts (4 on the bottom side), 35 nets.
