edgecollective/sweet-p/ver_0.4b/grassnomads_deployment_aug_2023/base/code.py

# Example to send a packet periodically between addressed nodes with ACK
# Author: Jerry Needell
#
import time
import alarm
import board
import busio
import digitalio
import adafruit_rfm9x
#from adafruit_onewire.bus import OneWireBus
#from adafruit_ds18x20 import DS18X20
import ipaddress
import ssl
import wifi
import socketpool
import adafruit_requests
import microcontroller
import struct
import adafruit_gps
import terminalio

node_id = 1

# Initialize one-wire bus on board pin D5.
#ow_bus = OneWireBus(board.D10)

# set the time interval (seconds) for sending packets
print_interval = 3

# Define radio parameters.
RADIO_FREQ_MHZ = 900.0  # Frequency of the radio in Mhz. Must match your
# module! Can be a value like 915.0, 433.0, etc.

# Define pins connected to the chip.
CS = digitalio.DigitalInOut(board.D11)
RESET = digitalio.DigitalInOut(board.D6)

# Initialize SPI bus.
spi = board.SPI()
# Initialze RFM radio
rfm9x = adafruit_rfm9x.RFM9x(spi, CS, RESET, RADIO_FREQ_MHZ)

# set node identity
rfm9x.node = node_id
# enable CRC checking
rfm9x.enable_crc = True
# set delay before sending ACK
rfm9x.ack_delay = 0.1
# set node addresses

#i2c = board.I2C()  # uses board.SCL and board.SDA
#gps = adafruit_gps.GPS_GtopI2C(i2c, debug=False)  # Use I2C interface
#gps.send_command(b"PMTK314,0,1,0,1,0,0,0,0,0,0,0,0,0,0,0,0,0,0,0")
#gps.send_command(b"PMTK220,1000")

try:
    from secrets import secrets
except ImportError:
    print("WiFi secrets are kept in secrets.py, please add them there!")
    raise

base_url = "http://bayou.pvos.org/data/"
public_key = secrets["bayou_public"]
private_key = secrets["bayou_private"]
JSON_POST_URL = base_url+public_key


def send(node_to,payload):
    rfm9x.destination = node_to
    if rfm9x.send_with_ack(payload):
        print("-->",node_to,payload)
        print("<--",node_to,"ACK")
    else:
        print("-->",node_to,payload)

def receive():
    packet = rfm9x.receive(with_ack=True, with_header=True)
    if packet is not None:
        node_from = packet[1]
        payload = "{0}".format(packet[4:])
        rssi = rfm9x.last_rssi
        #print("<--",node_from,"("+str(rssi)+")",payload)
        print("<--",node_from,"["+str(rssi)+"]",payload)
        return(packet)
    else:
        return(None)

print("-" * 40)
print("Waiting for packets...")
#time_now = time.monotonic()

#while True:
    #receive()
    # Scan for sensors and grab the first one found
    
#if time.monotonic() - time_now > transmit_interval:
    #time_now = time.monotonic()

index=0
time_now = time.monotonic()
while True:
    #print("hello")
    packet=receive()
    if packet is not None:
        
        #depth=30
        #try:
        payload = "{0}".format(packet[4:])
        #print(payload)
        c=eval(str(payload,"ascii"))
        #print(c)
        d=str(c,"ascii")
        #decs=d.strip()
        decs=d.split(",")
        print(decs)

        from_node=packet[1]
        if from_node == 2:
            node_id=2
            depth=str(int(decs[0])/1000.)
            batt_volts=str(decs[1])
            index = str(decs[2])
            sat_send_status = str(decs[3])
            attempt = str(decs[4])
            error_log = str(decs[5])
            #json_data = {"private_key":private_key, "node_id":node_id,"distance_meters":depth,"battery_volts":batt_volts,"rssi":rfm9x.last_rssi}
            #json_data = {"private_key":private_key, "node_id":node_id,"distance_meters":depth,"battery_volts":batt_volts,"rssi":rfm9x.last_rssi, "aux_1":index,"aux_2":sat_send_status,"aux_3":attempt}
            json_data = {"private_key":private_key, "node_id":node_id,"distance_meters":depth,"battery_volts":batt_volts,"rssi":rfm9x.last_rssi, "aux_1":index,"aux_2":sat_send_status,"aux_3":attempt,"log":error_log}
        if from_node == 3:
            node_id=3
            temp_c=decs[0]
            batt_volts=str(decs[1])
            json_data = {"private_key":private_key, "node_id":node_id,"temperature_c":temp_c,"battery_volts":batt_volts,"rssi":rfm9x.last_rssi}

        if(wifi.radio.ipv4_address==None):
                try:
                    print("Connecting to %s ..."%secrets["ssid"])
                    wifi.radio.connect(secrets["ssid"], secrets["password"])
                    print("Connected to %s!"%secrets["ssid"])
                    pool = socketpool.SocketPool(wifi.radio)
                    requests = adafruit_requests.Session(pool, ssl.create_default_context())
                except:
                    print("can't connect to wifi")
                
        if (wifi.radio.ipv4_address):
            #node_id=0
            #json_data = {"private_key":private_key, "node_id":node_id,"distance_meters":depth,"battery_volts":batt_volts,"rssi":rfm9x.last_rssi}
            response = None
            while not response:
                try:
                    response = requests.post(JSON_POST_URL, json=json_data)
                    failure_count = 0
                    print(response.text)
                except AssertionError as error:
                    print("Request failed, retrying...\n", error)
                    failure_count += 1
                    if failure_count >= attempts:
                        raise AssertionError(
                            "Failed to resolve hostname, \
                                            please check your router's DNS configuration."
                        ) from error
                    continue
        #except:
        #    print("error")
