edgecollective/sweet-p/ver_0.4b/firmware/display_depth.py

import board
import busio
import digitalio
import displayio
import time

uart = busio.UART(board.A4, board.D2, baudrate=9600)


def readline_until(end_char):
    line = ""
    while True:
        char = uart.read(1)
        if char:
            char = char.decode()
            if char == end_char:
                return line
            else:
                line += char



try:
    from i2cdisplaybus import I2CDisplayBus
except ImportError:
    from displayio import I2CDisplay as I2CDisplayBus

import terminalio
from adafruit_display_text import label
import adafruit_displayio_ssd1306

displayio.release_displays()

i2c = board.I2C()  # uses board.SCL and board.SDA
# i2c = board.STEMMA_I2C()  # For using the built-in STEMMA QT connector on a microcontroller
display_bus = I2CDisplayBus(i2c, device_address=0x3C)
display = adafruit_displayio_ssd1306.SSD1306(display_bus, width=128, height=64)

# Make the display context
splash = displayio.Group()
display.root_group = splash

color_bitmap = displayio.Bitmap(128, 32, 1)
color_palette = displayio.Palette(1)
color_palette[0] = 0xFFFFFF  # White

bg_sprite = displayio.TileGrid(color_bitmap, pixel_shader=color_palette, x=0, y=0)
splash.append(bg_sprite)

# Draw a smaller inner rectangle
inner_bitmap = displayio.Bitmap(118, 24, 1)
inner_palette = displayio.Palette(1)
inner_palette[0] = 0x000000  # Black
inner_sprite = displayio.TileGrid(inner_bitmap, pixel_shader=inner_palette, x=5, y=4)
splash.append(inner_sprite)

# Draw a label
text = "Hello World!"
text_area = label.Label(terminalio.FONT, text=text, color=0xFFFF00, x=28, y=15)
splash.append(text_area)

def get_depth():

    depth=-1
    for i in range(0,5):
        data = readline_until("\r")
        if data is not None:
            #print(data)
            depth_data=data.split(" ")
            if len(depth_data)==2:
                d1=depth_data[0]
                if (d1[0]=='R'):
                    depth=int(d1[1:])
    return(depth)
            
                
while True:
    
    depth=get_depth()
    print("depth=",depth)
    text_area.text="depth = "+str(depth)+" cm"
    time.sleep(1)
