edgecollective/sweet-p/ver_1/firmware/eeprom/sweet_eeprom.py

import board
import struct
import adafruit_24lc32

# Initialize I2C and EEPROM
i2c = board.I2C()
eeprom = adafruit_24lc32.EEPROM_I2C(i2c, address=0x57)

# 4 integers to write to EEPROM
#wakeup_stats = [5, 13, 18, 25]  #hour1, hour2, hour3, day of month

wakeup_times = [5, 13, 18]  #hour1, hour2, hour3, day of month

wakeup_stats = [0, 0, 0, 25]

def write_to_eeprom(integers_to_write):
    # Convert integers to bytes and write to EEPROM
    # Each integer takes 4 bytes, so we'll use addresses 0, 4, 8, 12
    print("Writing integers to EEPROM...")
    print(f"Original integers: {integers_to_write}")
    
    for i, value in enumerate(integers_to_write):
        # Pack integer as 4-byte signed integer (little-endian)
        byte_data = struct.pack('<i', value)
        start_addr = i * 4
        
        # Write the 4 bytes to EEPROM
        for j, byte in enumerate(byte_data):
            eeprom[start_addr + j] = byte
        
        print(f"Wrote integer {value} to EEPROM at address {start_addr}")
    
def read_from_eeprom():
    print("\nReading integers from EEPROM...")

    # Read back the integers
    retrieved_integers = []
    for i in range(4):
        start_addr = i * 4
        
        # Read 4 bytes from EEPROM as a slice (returns bytearray)
        byte_data = eeprom[start_addr:start_addr + 4]
        
        # Unpack bytes back to integer
        retrieved_value = struct.unpack('<i', byte_data)[0]
        retrieved_integers.append(retrieved_value)
        
        print(f"Read integer {retrieved_value} from EEPROM at address {start_addr}")
    
    return(retrieved_integers)

print(f"Original integers:  {wakeup_stats}")

write_to_eeprom(wakeup_stats)

new_stats = read_from_eeprom()
print(f"\nRetrieved integers: {new_stats}")
