edgecollective/sweet-p/ver_1/firmware/test2/t3/code.py

import board
import struct
import time
import displayio
import terminalio
from adafruit_display_text import label
import adafruit_24lc32
import adafruit_ds3231
import adafruit_displayio_ssd1306
from adafruit_rockblock import RockBlock
import digitalio

sat_power_pin = digitalio.DigitalInOut(board.D9)
sat_power_pin.direction = digitalio.Direction.OUTPUT
sat_power_pin.value = False

# Compatibility with both CircuitPython 8.x.x and 9.x.x
try:
    from i2cdisplaybus import I2CDisplayBus
except ImportError:
    from displayio import I2CDisplay as I2CDisplayBus

# Configuration
WAKEUP_TIMES = [15,30,45]  # minutes to wake up
MAX_RETRY = 3
SLEEP_BETWEEN = 5
DAYS = ("Monday", "Tuesday", "Wednesday", "Thursday", "Friday", "Saturday", "Sunday")

def init_hardware():
    """Initialize hardware components (without RockBlock modem)"""
    #try:
    # Initialize I2C
    i2c = board.I2C()
    
    # Initialize display
    displayio.release_displays()
    display_bus = I2CDisplayBus(i2c, device_address=0x3C)
    display = adafruit_displayio_ssd1306.SSD1306(display_bus, width=128, height=64)
    
    # Initialize EEPROM and RTC
    eeprom = adafruit_24lc32.EEPROM_I2C(i2c, address=0x57)
    rtc = adafruit_ds3231.DS3231(i2c)
    
    return i2c, display, eeprom, rtc
    #except Exception as e:
    #    print(f"Hardware initialization failed: {e}")
    #    return None, None, None, None

def init_rockblock():
    """Initialize RockBlock modem only when needed"""
    try:
        sat_power_pin.value = True
        uart = board.UART()
        uart.baudrate = 19200
        rb = RockBlock(uart)
        return rb
    except Exception as e:
        print(f"RockBlock initialization failed: {e}")
        return None

def setup_display(display):
    """Setup display with labels"""
    try:
        splash = displayio.Group()
        display.root_group = splash
        
        wakeup_area = label.Label(terminalio.FONT, text="", color=0xFFFF00, x=5, y=5)
        stats_area = label.Label(terminalio.FONT, text="", color=0xFFFF00, x=5, y=15)
        time_area = label.Label(terminalio.FONT, text="", color=0xFFFF00, x=5, y=25)
        status_area = label.Label(terminalio.FONT, text="", color=0xFFFF00, x=5, y=35)
        detail_area = label.Label(terminalio.FONT, text="", color=0xFFFF00, x=5, y=45)
        
        splash.append(wakeup_area)
        splash.append(stats_area)
        splash.append(time_area)
        splash.append(status_area)
        splash.append(detail_area)
        
        return wakeup_area, stats_area, time_area, status_area, detail_area
    except Exception as e:
        print(f"Display setup failed: {e}")
        return None, None, None, None, None

def write_to_eeprom(eeprom, integers_to_write):
    """Write integers to EEPROM with error handling"""
    try:
        print(f"Writing to EEPROM: {integers_to_write}")
        for i, value in enumerate(integers_to_write):
            byte_data = struct.pack('<i', value)
            start_addr = i * 4
            for j, byte in enumerate(byte_data):
                eeprom[start_addr + j] = byte
        return True
    except Exception as e:
        print(f"EEPROM write failed: {e}")
        return False

def read_from_eeprom(eeprom):
    """Read integers from EEPROM with error handling"""
    try:
        print("Reading from EEPROM...")
        retrieved_integers = []
        for i in range(3):
            start_addr = i * 4
            byte_data = eeprom[start_addr:start_addr + 4]
            retrieved_value = struct.unpack('<i', byte_data)[0]
            retrieved_integers.append(retrieved_value)
        return retrieved_integers
    except Exception as e:
        print(f"EEPROM read failed: {e}")
        return [0, 0, 0]  # Return default values

def update_display(wakeup_area, stats_area, time_area, status_area, detail_area, rtc, stats, status_msg="", detail_msg=""):
    """Update display with current information"""
    try:
        t = rtc.datetime
        wakeup_area.text = "wakeup: " + ' '.join(str(item) for item in WAKEUP_TIMES)
        stats_area.text = "stats: " + ' '.join(str(item) for item in stats)
        time_area.text = f"hr:{t.tm_hour:02} min:{t.tm_min:02} sec:{t.tm_sec:02}"
        status_area.text = status_msg
        detail_area.text = detail_msg
    except Exception as e:
        print(f"Display update failed: {e}")

def send_satellite_message(rb, message, display_areas=None):
    """Send message via satellite with retry logic"""
    try:
        rb.text_out = message
        print("Talking to satellite...")
        status = rb.satellite_transfer()
        
        if display_areas:
            wakeup_area, stats_area, time_area, status_area, detail_area, rtc, stats = display_areas
            update_display(wakeup_area, stats_area, time_area, status_area, detail_area, rtc, stats, 
                          "Attempting send...", f"Initial Status: {status[0]}")
        
        retry = 0
        while status[0] > 8 and retry < MAX_RETRY:
            status = rb.satellite_transfer()
            print(f"Retry {retry}, status: {status}")
            
            if display_areas:
                update_display(wakeup_area, stats_area, time_area, status_area, detail_area, rtc, stats, 
                              "Attempting send...", f"Retry {retry+1}/{MAX_RETRY} Status: {status[0]}")
            
            retry += 1
            time.sleep(SLEEP_BETWEEN)
        
        return status[0] <= 8
    except Exception as e:
        print(f"Satellite communication failed: {e}")
        return False

def main():
    """Main program logic"""
    # Initialize hardware (excluding RockBlock)
    i2c, display, eeprom, rtc = init_hardware()
    if not all([i2c, display, eeprom, rtc]):
        print("Critical hardware initialization failed!")
        return
    
    # Setup display
    wakeup_area, stats_area, time_area, status_area, detail_area = setup_display(display)
    if not all([wakeup_area, stats_area, time_area, status_area, detail_area]):
        print("Display setup failed!")
        return
    
    # Get current time and stats
    try:
        t = rtc.datetime
        print(f"The date is {DAYS[int(t.tm_wday)]} {t.tm_mday}/{t.tm_mon}/{t.tm_year}")
        print(f"The time is {t.tm_hour}:{t.tm_min:02}:{t.tm_sec:02}")
        
        stats = read_from_eeprom(eeprom)
        update_display(wakeup_area, stats_area, time_area, status_area, detail_area, rtc, stats)
        
        # Find the latest send time we've passed
        latest_send_time_index = -1
        for i in range(len(WAKEUP_TIMES)):
            this_minute=WAKEUP_TIMES[i]
            if (this_minute<=t.tm_min) and (stats[i]!=t.tm_hour):
                latest_send_time_index=i
                
        #for i, wake_minute in enumerate(WAKEUP_TIMES):
        #    if wake_minute <= t.tm_min:
        #        latest_send_time_index = i
        
        print(f"Latest send time index: {latest_send_time_index}")
        
        # Send message if we've reached a send time
        if latest_send_time_index >= 0:
            # Initialize RockBlock only when we need to send
            update_display(wakeup_area, stats_area, time_area, status_area, detail_area, rtc, stats, "Initializing modem...", "")
            rb = init_rockblock()
            
            if rb is None:
                print("Failed to initialize RockBlock!")
                update_display(wakeup_area, stats_area, time_area, status_area, detail_area, rtc, stats, "Modem init failed", "Cannot send")
                return
            
            display_areas = (wakeup_area, stats_area, time_area, status_area, detail_area, rtc, stats)
            
            update_display(wakeup_area, stats_area, time_area, status_area, detail_area, rtc, stats, "Attempting to send...", "")
            success = send_satellite_message(rb, "hello world", display_areas)
            
            if success:
                print("MESSAGE SENT")
                # Update stats for all send times up to and including current
                for i in range(latest_send_time_index + 1):
                    stats[i] = t.tm_hour
                write_to_eeprom(eeprom, stats)
                update_display(wakeup_area, stats_area, time_area, status_area, detail_area, rtc, stats, "Send successful", "Completed")
            else:
                print("MESSAGE FAILED TO SEND")
                update_display(wakeup_area, stats_area, time_area, status_area, detail_area, rtc, stats, "Send failed", "Max retries reached")
            
            # Power down RockBlock after use
            sat_power_pin.value = False
        else:
            update_display(wakeup_area, stats_area, time_area, status_area, detail_area, rtc, stats, "Not time to send", "")
            time.sleep(5)
            
    except Exception as e:
        print(f"Main execution error: {e}")
    
    time.sleep(5) # to allow for us to see the display
    
    done_pin = digitalio.DigitalInOut(board.D7)
    done_pin.direction = digitalio.Direction.OUTPUT
    done_pin.value = True

if __name__ == "__main__":
    main()
    # Sleeping
    #done_pin = digitalio.DigitalInOut(board.D7)
    #done_pin.direction = digitalio.Direction.OUTPUT
    #done_pin.value = True
