edgecollective/sweet-p/ver_1/firmware/eeprom/test_eeprom.py

# SPDX-FileCopyrightText: Copyright (c) 2021 Tim Cocks for Adafruit Industries
#
# SPDX-License-Identifier: Unlicense

import board

import adafruit_24lc32

i2c = board.I2C()  # uses board.SCL and board.SDA
# i2c = board.STEMMA_I2C()  # For using the built-in STEMMA QT connector on a microcontroller
eeprom = adafruit_24lc32.EEPROM_I2C(i2c,address=0x57)

print(f"length: {len(eeprom)}")

eeprom[0] = 4
print(eeprom[0])

eeprom[0:4] = [9, 3, 88, 1]

eeprom[10]=3
print(eeprom[10])
