edgecollective/sweet-p/ver_0.4b/firmware/write_boot.py

# SPDX-FileCopyrightText: 2021 Kattni Rembor for Adafruit Industries
#
# SPDX-License-Identifier: MIT

"""
boot.py file for Pico data logging example. If pin GP0 is connected to GND when
the pico starts up, make the filesystem writeable by CircuitPython.
"""
import board
import digitalio
import storage

write_pin = digitalio.DigitalInOut(board.D11)
write_pin.direction = digitalio.Direction.INPUT
write_pin.pull = digitalio.Pull.UP

# If write pin is connected to ground on start-up, CircuitPython can write to CIRCUITPY filesystem.
if not write_pin.value:
    storage.remount("/", readonly=False)
