edgecollective/sweet-p/ver_0.4b/firmware/utilities/radio_test/secrets.py

# SPDX-FileCopyrightText: 2020 Adafruit Industries
#
# SPDX-License-Identifier: Unlicense

# This file is where you keep secret settings, passwords, and tokens!
# If you put them in the code you risk committing that info or sharing it

secrets = {
    'ssid' : 'Fios-7S5yS_EXT',
    'password' : 'whose44gel62has',
    'bayou_public' : 'hynj3bxfuzst',
    'bayou_private' : 'gyh3qfryma8q',
    'timezone' : "America/New_York", # http://worldtimeapi.org/timezones
    }
