edgecollective/sweet-p/(commit log)

2023-05-06 laid out power
    [sweet-p.kicad_pcb, sweet-p.kicad_sch]
2023-05-06 fully routed
    [sweet-p.kicad_pcb]
2023-07-23 good layout -- need to check resistor locations
    [sweet-p.kicad_pcb]
2023-07-23 fleshed out the power train
    [sweet-p.kicad_pcb, sweet-p.kicad_sch]
2023-07-23 fixed breakout
    [sweet-p.kicad_pcb, sweet-p.kicad_sch]
2023-07-25 continuing routing
    [sweet-p.kicad_pcb]
2023-07-25 nearly all routed
    [sweet-p.kicad_pcb, sweet-p.kicad_sch]
2023-07-26 final layout and gerbers
    [sweet-p-B_Cu.gbr, sweet-p-B_Mask.gbr, sweet-p-B_Paste.gbr, sweet-p-B_Silkscreen.gbr, sweet-p-Edge_Cuts.gbr, sweet-p-F_Cu.gbr, sweet-p-F_Mask.gbr, sweet-p-F_Paste.gbr]
2024-01-09 this is a mistake
    [all_around_display.py, base.py, button_test.py, code.py, code_from_jan_9.py, ds3231_simpletest.py, gps_simpletest.py, gps_time.py]
2024-01-09 Revert "this is a mistake"
    This reverts commit 5cc8ff005acb2d47508dfea686df135778592703.
    [all_around_display.py, base.py, button_test.py, code.py, code_from_jan_9.py, ds3231_simpletest.py, gps_simpletest.py, gps_time.py]
2024-11-02 updated ver 0.4 sweet-p
    [RockBLOCK_2_C (SMA).IGS, RockBLOCK_2_C (SMA).STEP, RockBLOCK_2_C.IGS, RockBLOCK_2_C.STEP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]
2024-11-02 pin assignments and initial layout for ver 0.4
    [sweet-p.kicad_pcb, sweet-p.kicad_sch]
2024-11-02 fully routed v4
    [sweet-p.kicad_pcb]
2024-11-16 added force send button
    [RockBLOCK_2_C (SMA).IGS, RockBLOCK_2_C (SMA).STEP, RockBLOCK_2_C.IGS, RockBLOCK_2_C.STEP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]
2025-08-17 interrupt_itsy is the shizzle
2025-10-10 ver 1 completed
    [sweet-p-B_Cu.gbr, sweet-p-B_Mask.gbr, sweet-p-B_Paste.gbr, sweet-p-B_Silkscreen.gbr, sweet-p-Edge_Cuts.gbr, sweet-p-F_Cu.gbr, sweet-p-F_Mask.gbr, sweet-p-F_Paste.gbr]
